wangrunji0408/CPUProject/Project4/DCM.vhd

--------------------------------------------------------------------------------
-- Copyright (c) 1995-2013 Xilinx, Inc.  All rights reserved.
--------------------------------------------------------------------------------
--   ____  ____ 
--  /   /\/   / 
-- /___/  \  /    Vendor: Xilinx 
-- \   \   \/     Version : 14.7
--  \   \         Application : xaw2vhdl
--  /   /         Filename : DCM.vhd
-- /___/   /\     Timestamp : 12/09/2017 23:02:55
-- \   \  /  \ 
--  \___\/\___\ 
--
--Command: xaw2vhdl-intstyle Z:/Documents/Codes/Tsinghua/Grade3-1/CPU/Project4/ipcore_dir/DCM.xaw -st DCM.vhd
--Design Name: DCM
--Device: xc3s1200e-4fg320
--
-- Module DCM
-- Generated by Xilinx Architecture Wizard
-- Written for synthesis tool: XST
-- Period Jitter (unit interval) for block DCM_SP_INST = 0.04 UI
-- Period Jitter (Peak-to-Peak) for block DCM_SP_INST = 0.92 ns

library ieee;
use ieee.std_logic_1164.ALL;
use ieee.numeric_std.ALL;
library UNISIM;
use UNISIM.Vcomponents.ALL;

entity DCM is
   port ( CLKIN_IN        : in    std_logic; 
          RST_IN          : in    std_logic; 
          CLKFX_OUT       : out   std_logic; 
          CLKIN_IBUFG_OUT : out   std_logic; 
          CLK0_OUT        : out   std_logic; 
          LOCKED_OUT      : out   std_logic);
end DCM;

architecture BEHAVIORAL of DCM is
   signal CLKFB_IN        : std_logic;
   signal CLKFX_BUF       : std_logic;
   signal CLKIN_IBUFG     : std_logic;
   signal CLK0_BUF        : std_logic;
   signal GND_BIT         : std_logic;
begin
   GND_BIT <= '0';
   CLKIN_IBUFG_OUT <= CLKIN_IBUFG;
   CLK0_OUT <= CLKFB_IN;
   CLKFX_BUFG_INST : BUFG
      port map (I=>CLKFX_BUF,
                O=>CLKFX_OUT);
   
   CLKIN_IBUFG_INST : IBUFG
      port map (I=>CLKIN_IN,
                O=>CLKIN_IBUFG);
   
   CLK0_BUFG_INST : BUFG
      port map (I=>CLK0_BUF,
                O=>CLKFB_IN);
   
   DCM_SP_INST : DCM_SP
   generic map( CLK_FEEDBACK => "1X",
            CLKDV_DIVIDE => 2.0,
            CLKFX_DIVIDE => 5,
            CLKFX_MULTIPLY => 4,
            CLKIN_DIVIDE_BY_2 => FALSE,
            CLKIN_PERIOD => 20.000,
            CLKOUT_PHASE_SHIFT => "NONE",
            DESKEW_ADJUST => "SYSTEM_SYNCHRONOUS",
            DFS_FREQUENCY_MODE => "LOW",
            DLL_FREQUENCY_MODE => "LOW",
            DUTY_CYCLE_CORRECTION => TRUE,
            FACTORY_JF => x"C080",
            PHASE_SHIFT => 0,
            STARTUP_WAIT => FALSE)
      port map (CLKFB=>CLKFB_IN,
                CLKIN=>CLKIN_IBUFG,
                DSSEN=>GND_BIT,
                PSCLK=>GND_BIT,
                PSEN=>GND_BIT,
                PSINCDEC=>GND_BIT,
                RST=>RST_IN,
                CLKDV=>open,
                CLKFX=>CLKFX_BUF,
                CLKFX180=>open,
                CLK0=>CLK0_BUF,
                CLK2X=>open,
                CLK2X180=>open,
                CLK90=>open,
                CLK180=>open,
                CLK270=>open,
                LOCKED=>LOCKED_OUT,
                PSDONE=>open,
                STATUS=>open);
   
end BEHAVIORAL;
