wangrunji0408/CPUProject/(commit log)

2017-10-17 Add Project2 Framework.
2017-10-19 Update Pin
2017-10-19 Fix SRA. Add test for Top.
    [alu.vhd, test_top.vhd]
2017-10-27 Change input cycle. Add test for flags. (Test Failed)
    [base.vhd, test_alu.vhd, test_top.vhd, top.vhd]
2017-11-01 Fix enable=0. Add UART entity. Add key[3..0]
    [fake_ram.vhd, ram_proj.vhd, top.vhd, uart_proj.vhd]
2017-11-02 Fix bug of writing UART. Finish Project3.
    [ram_uart.vhd, uart_proj.vhd]
2017-11-17 Fix ALU operator, remove flags.
    [Alu.vhd, base.vhd]
2017-11-19 Fix VGA, pass on board.
    [FontReader.vhd, Renderer.vhd, test_vga.vhd, top.vhd]
2017-11-22 Fix Reg test. Add debug output for Reg, print in Renderer.
    [Base.vhd, Reg.vhd, Renderer.vhd, _CPU.vhd, test_reg.vhd, top.vhd]
2017-11-22 Fix RamUartCtrl, pass test with MockRam & MockUart.
    [Ctrl.vhd, MockRam.vhd, MockUart.vhd, RamUartCtrl.vhd, _CPU.vhd, test_ruc.vhd]
2017-11-22 finish id block with its all 30 commands fixes#7
    [Base.vhd, ID.vhd]
2017-11-23 Print all CPU debug info to VGA.
2017-11-23 Begin global simulation. Fix huge bugs.
    [Base.vhd, ID.vhd, KernelData.vhd, MEM.vhd, MockRam.vhd, RamUartCtrl.vhd, Reg.vhd, _CPU.vhd]
2017-11-23 Fix bypass. Pass some tests for MEM.
    [EX.vhd, ID.vhd, MEM.vhd, _CPU.vhd]
2017-11-23 Can run term to OK in simulation. Fix some bugs. Add Flash/RAM & TermTest exe.
    [Ctrl.vhd, ID.vhd, IF_ID.vhd, MockRam.vhd, RamUartCtrl.vhd, _CPU.vhd, test_top.vhd]
2017-11-25 Try to fix ID. Change PC.
    [ID.vhd, RamUartCtrl.vhd, test_ruc_top.vhd]
2017-11-25 Can run CPU on board !! Fix VGA.
    [Base.vhd, Renderer.vhd, top.vhd]
2017-11-26 Fix MockUart, RamUartCtrl. Improve Renderer. Now 25MHz.
    [Base.vhd, Ctrl.vhd, MEM.vhd, MockUart.vhd, RamUartCtrl.vhd, Renderer.vhd, top.vhd]
2017-11-27 Update kernel.bin & .txt . Fix Ctrl on IF conflict. Disable EX/MEM Clear. Add IOLogger (bug).
    [Base.vhd, Ctrl.vhd, DCM.vhd, EX_MEM.vhd, IOLogger.vhd, MockRam.vhd, MockUart.vhd, Reg.vhd]
2017-11-27 Fix IOLogger, pass on ISim.
    [IOLogger.vhd]
2017-11-28 Change UART to non-blocking.
2017-11-29 Can run kernel & performance test !! Fix UART can-write flag. Add DataBuffer (unfinished).
    [AsciiToBufferInput.vhd, Base.vhd, DCM.vhd, DataBuffer.vhd, IOLogger.vhd, RamUartCtrl.vhd, Renderer.vhd]
2017-11-30 Change read UART to 2 cycle.
2017-12-02 Fix Boot. Run on 40MHz.
    [AsciiToBufferInput.vhd, Base.vhd, Boot.vhd, ClkDiv.vhd, DCM.vhd, DataBuffer.vhd, RamUartCtrl.vhd, Renderer.vhd]
2017-12-06 Fix Renderer, pass on board. Bug in DCM compiling.
    [DCM.vhd, Renderer.vhd, top.vhd]
2017-12-08 扩展指令的测试，extra.s,extra.bin
2017-12-08 Basic asm programs & compiler. Fix map error.
    [RamUartCtrl.vhd, top.vhd]
2017-12-08 Fix extra inst (SLTUI). Change program suffixs to .s
    [EX.vhd, ID.vhd, IOLogger.vhd, test_top.vhd]
2017-12-08 print INT
2017-12-09 correct the write logic
    [hard_term.vhd]
2017-12-09 Fix compile error. Update asm.
    [DataBuffer.vhd, Shell.vhd, hard_term.vhd, top.vhd]
2017-12-09 修复了内核态也可以中断的Bug。Ctrl-D中断改为标准中断。
2017-12-09 Revert CPU for unbelievable Bug!
    [_CPU.vhd]
2017-12-09 fix some bug in hard_term
    [DataBuffer.vhd, hard_term.vhd, top.vhd]
2017-12-10 fix bug of CmdG
    [hard_term.vhd]
2017-12-10 Fix CPU signals. Fix boot size.
    [_CPU.vhd, top.vhd]
2017-12-10 fix bug of CmdU
    [hard_term.vhd]
2017-12-10 fix bug of CmdA
    [hard_term.vhd]
2017-12-17 report中添加了MEM，Reg和中断的相关内容
